sleieur/ti60-bitblt-engine/docs/fig_system.png

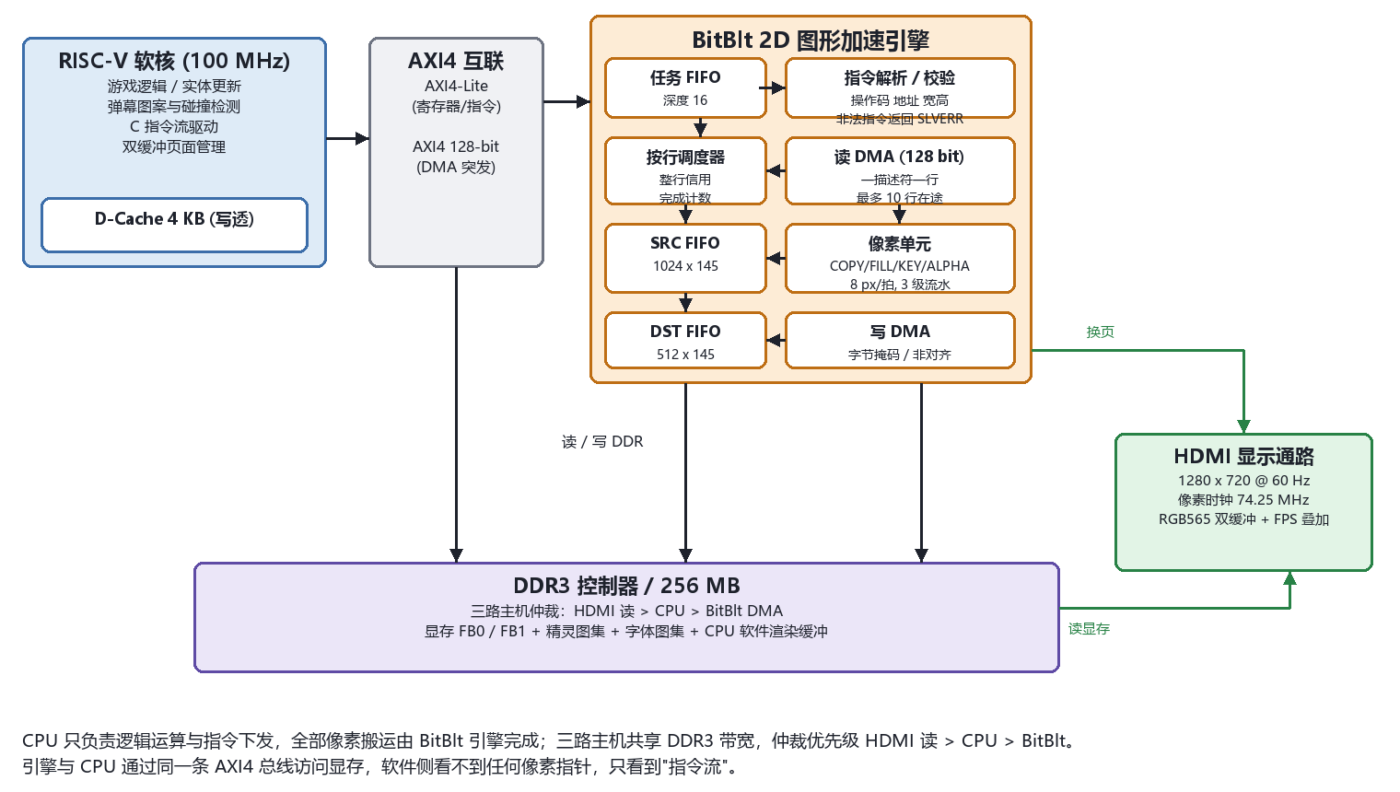
docs/fig_system.png
