sleieur/ti60-bitblt-engine/(commit log)

2026-11-03 feat: 异构 2D 图形渲染加速引擎（Ti60F225 + RISC-V BitBlt）
    硬件
    - BitBlt 流水线：任务 FIFO、二维拆解、行级信用、8 px/clk 像素流水线
    - FILL / COPY / COLOUR KEY / ALPHA 四类运算复用同一数据通路
    - 128 bit AXI4 读写主机 + SRC/DST FIFO，把零散行访问聚合成突发
    - 双缓冲换页（FRAME_LAST）+ HDMI 1280x720@60 时序 + 硬件 FPS 叠字
    - 三主机仲裁：HDMI 读 > CPU > BitBlt
    软件
    - 十场演示：分屏软硬件对比、图片与 GIF、α 混合、色键、弹幕游戏、
    精灵数极限（AIMD 探针）、片上自校验（163 840 像素逐点比对）
    - 主机端预览器复用同一份 scenes.c，改界面不必反复烧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
2026-11-03 ci: 增加轻量 sanity 检查与徽章
    - 主机侧工具链 python 语法检查
    - RTL / 固件源文件完整性
    - 有 iverilog 时做语法检查，没有则跳过（以 Efinity 综合结果为准）
    - README 顶部补充 CI 与 release 徽章
2026-11-03 docs: 增加性能对比图，徽章改用绝对链接
    - docs/fig_perf.png：整屏操作耗时与 16.7 ms 帧预算对照，CPU 一帧预算外的对比一目了然
    - README 徽章与 Release 链接改为绝对地址，避免相对路径在镜像/子页失效
2026-11-04 feat(game): 街机化美术 —— 像素化精灵 + 远景行星 + 速度线
    不动物理引擎与任何 RTL，只在软件侧改绘制，帧预算仍是 60 FPS 的那一份。
    精灵（art.c）
    - 新增三道后处理：按 cell x cell 块量化（取块内众数而不是均值，保住高光
    与配色条纹）、压到 16 色街机调色板、沿轮廓描一圈墨线
    - 轮廓改成三种角色差异明显的剪影：快攻镖、宽翼轰炸机、小型无人机；
    原来两侧同时收敛，三个敌机在屏上都是圆饼
    - 玩家机整体 —— 64 px 在 1280 宽的屏上只有 1/20，读起来是个远处的小点，
    所以把成品做最近邻 2 倍放大到 128 px，像素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
2026-11-04 feat(game): Boss 放大到 2 倍，占据画面上三分之一
    224 px 的 Boss 在 1280 px 宽屏上只是中 Boss 的体量，读不出压迫感。
    最近邻放大到 448 px 后，环形机械体加发光核心才有街机 Boss 的分量；
    弹幕结构、血量与判定完全不变。
2026-11-04 feat(art): 星云噪声、光爆、去洋红边缘
    背景
    - 星云从"径向渐变"改成三层哈希噪声：形状由噪声闸门决定，半径只调亮度，
    所以不会再出现一个边缘完整的圆盘；用密度抖动冒充 alpha，仍是 KEY 精灵
    - 行星换暖灰系色带（原来是近黑，远看是一个洞），去掉墨线描边 ——
    360 px 圆盘描边量化后是一圈白虚线，像选中框
    特效
    - 新增两档光爆（96 px 击杀 / 240 px Boss 核心）：白色内核 + 抖动衰减光晕，
    击杀时先闪再散
    - 新增 key_clean 后处理：凡是落在洋红家族的像素一律归成品红。
    原来的光球描边渐隐到接近 0xF81F，差一两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
2026-11-04 fix(game): 玩家机与 Boss 恢复原始尺寸
    2 倍放大让两者压在playfield之上而不是在其中：720p 上街机比例是
    玩家 64 px、Boss 224 px，风格靠像素网格而不是体积。
    引擎焰位置同步回到 +20。
    [art.c, game.c]
2026-11-04 feat(art): 接入 RUOK / Kenney CC0 手绘素材
    素材
    - 敌机、Boss、子弹改用 RUOK Space Construction Set（CC0）
    - Boss 由异形头 3 倍放大 + 左右镜像轨道炮组成，读起来是一台机械
    - 子弹切成 18/30/50 三档长度：原来全屏都是 50 px 长条，糊成一片
    管道
    - tools/pack_game.py：切帧（偶数分格 + 逐帧裁边）、压品红键、生成
    GAME_ASSET_ADDR 处的图集，21 个精灵 237 KiB
    - tools/load_game_assets.ps1：与载图片同一套 openocd 流程，一次性写入 DDR
    - 固件启动检测 'GPAK' 魔数：有素材用手绘，没有就退回程序化，不会黑屏
    踩到的两个坑（已修，写进注释）
    - 图集偏移已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
2026-11-04 revert(art): 默认关闭手绘素材包，回到程序化美术
    素材包代码与打包/加载工具都保留在仓库里（USE_ART_PACK 开关），但默认置 0。
    原因是实际效果：64 px 的霓虹精灵在 1280x720 上放大三倍之后，色块和描边
    互相打架，画面比按显示器尺度绘制的程序化版本更乱。素材本身的画风没问题，
    是尺寸与分辨率不匹配。
    同时恢复天空渐变的蓝色雾气（此前为了让霓虹精灵发光而压暗过）。
    固件 60630 B，RAM 97.19%。
    [art.c, art.h, game.c]
2026-11-04 feat(art): 气态巨行星重画（带环、有晨昏线）
    原来那颗是"贴上去的灰饼"：色带直着走、没有明暗方向、边缘色带硬切。
    新版
    - 色带随球面弯曲（纬度用 dy + dx^2/6R，不是单纯 y），100 px 大小下才像球而不是盘子
    - 兰伯特光照，光源在左上：整数点积先放大 100 倍再除，否则整除把整个圆盘压成 0，
    只剩边缘一圈亮（第一版就是这么画成黑球的）
    - 边缘冷色大气，晨昏线在右侧自然收暗
    - 环分两次画：远侧先画（随后被球体遮住），近侧画在球体之上，
    穿过圆盘时压暗但保留暖色，读作半透明环而不是灰条
    - 分块时按 RGB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
2026-11-04 feat(scene8): 压力测试改成幸存者式尸潮（六关递进）
    原来的探针只证明"能画多少个"，看不出是什么游戏。现在是同类游戏里天然
    适合压测的形态：怪从屏幕外圈刷进来、武器全自动、负载随关卡翻倍。
    学习后的取舍（参考 Godot 社区 survivors-like 实践）
    - 波次用「每秒速率累加」而不是定时器，能表达 26.4 只/秒这种小数速率
    - 池化 + 打包数组 + swap-remove，不设空闲表，遍历就是一段连续内存
    - 敌人直线追玩家，不做寻路；这是该品类的通行做法，也省掉 A*
    - 放弃逐子弹 vs 逐敌人碰撞：760x240 = 18 万次距离测试，100 MHz 核做不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
    [art.c, art.h, scenes.c]
2026-11-04 perf(scene8): 六关压到 27 秒，并修掉三个被预览暴露的缺陷
    节奏
    - 每关 12 s 改成 4.5 s，六关共 27 s，场景停留 30 s
    - 刷怪环改为围绕玩家（半径 520）而不是屏幕中心：尸潮从四面八方合围，
    画面铺满而不是堆在玩家站的那一侧
    - 接触伤害改成每 24 帧一次，只扣一点：原来 8 帧一次，12 秒就把船打爆，
    结尾变成 HULL BREACH
    修掉的三个缺陷
    1. 精灵堆基址 0x05000000 正好压在自校验缓冲区 CHK_SRC 上，
    场景 9 会覆盖前 160 KiB 精灵 —— 之后所有场景的贴图都是坏的。
    移到 0x04400000（CPU 对比页与图片条带之间的空档）
    2. 冲击环用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
2026-11-04 fix(scene8): 敌人改为固定朝向来流，修掉十字线伪影
    每帧重新瞄准玩家会让敌人越过他之后反向，最终在玩家所在的行和列上来回
    震荡，屏幕上出现一横一竖两条密集的"死线"。
    改成出生时定一次朝向、只沿该方向走，从对面出界后重投到场边并重新定向，
    尸潮变成斜向穿场的流动，画面才像该品类该有的样子。
    六关同屏实测：30 → 73 → 220 → 450 → 760
    ram 95.77%，bbShow.bin 65894 B
    [scenes.c]
2026-11-04 feat(scene8): 重做成真正的俯视幸存者（斜二测 + 地面地图 + 刀枪）
    上一版被指出的问题，逐条改掉：
    1. 玩家不再是飞机 —— 改成斜二测人物：脚底投影椭圆、双腿、躯干、头盔面罩、
    横持的步枪。斜二测（伪 3D）是这类游戏的画法，纯俯视看谁都像个圆盘。
    2. 敌人不再围在玩家身边生成 —— 改为按周长均匀分布在**地图四边**，走进来
    以后再越过玩家，从对面出界重投。
    3. 两条密集死线 —— 根因是每帧重新瞄准导致来回反向震荡。现在每 24 帧
    重瞄一次，且速度是矢量式（不是逐轴步进），不会在轴线上堆积。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
    [art.c, art.h, scenes.c]
2026-11-04 feat: 演示顺序改为 幸存者压力测试 → STARFALL → 其余
    上电直接进压力测试，跑完 30 秒接 STARFALL，再看总览与其余场景。
    顺序放在一张表里（SCENE_ORDER），而不是重排场景编号：
    屏幕菜单上的编号是给人记的，改了编号反而对不上。
    自动轮播、空格键、Boss 击破后的交接三处都走 scene_next()，顺序天然一致；
    表尾回卷到压力测试，循环演示不会再落到标题页上。
2026-11-04 feat(scene8): 慢怪、拉开大小差、武器随关卡升级并置顶
    按反馈改的四件事：
    1. 移速
    - 全局速度降到 2/1（原来 3 + 关卡加成），并和体型挂钩：绿色小兵最快、
    橙色重甲最慢
    - 主角活动范围放大（±300 x, ±170 y），身后留出空地，刀和弹道才看得见
    2. 地图
    - 加入大尺度地貌噪声（约 300 px 一块），干湿两种草地交替
    - 换成两块裸土斑块（原来画水塘，RGB565 下必然发荧光）
    - 土路改成 smoother 的抛物线，红分量压到 9/32（之前写 40 被钳成满红，路是粉的）
    3. 武器升级（同时是压力曲线）
    - 第 1 关 单发手枪
    -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
2026-11-04 feat: 婕旂ず椤哄簭鍥炲埌鑿滃崟椤哄簭锛屾崲鐢ㄦ柊瀹炴媿鐨勫案娼笌 STARFALL 鎴浘
    - SCENE_ORDER 鎭㈠涓?鏍囬椤?鈫?鍥涗釜鍒嗛」 鈫?KEY 鈫?STARFALL 鈫?灏告疆鍘嬫祴 鈫?鑷牎楠?鈫?鎬荤粨锛屼笂鐢佃惤鍦ㄦ爣棰橀〉
    - 璁捐鎶ュ憡鎹㈡垚闃熷弸閲嶆帓鐗堬紝骞舵妸绗?8 鍦烘敼鍐欎负鍏叧灏告疆鍘嬪姏娴嬭瘯锛堝嘲鍊?933 鍙紝绗?6 鍏冲彔鍔?3 閬撴縺鍏夊悗 48~54 FPS锛夛紝鏇挎崲鍥?14/15 鐨勫疄鎷嶆埅鍥?- README 涓庢簮鐮佽鏄庨噷鐨勭簿鐏垫暟鎸囨爣鐢?1024/1280 鏇存柊涓哄帇娴嬪疄娴嬪€?- bbShow.bin 闅忔簮鐮侀噸缂栬瘧
